SuperCoolAlan/wrx-manifests/systems/brake-notes.md

# Brake Notes — 04 WRX Chassis, Track Build

**Date:** 2026-08-19
**Build context:** 2004 USDM WRX chassis + 05-era EJ257, FP Red, E85, target 500whp, **mostly track use**
**Status:** Interim setup installed and adequate for 2026 season. Brembo upgrade planned as winter project.

---

## Current Configuration

### Confirmed (stated by Alan, 2026-08-19)

- **Front calipers:** OEM Subaru 4-piston, red, from a **2007 WRX Limited** (GD hawkeye)
- **Rear calipers:** OEM Subaru 2-piston, same donor era
- **Front knuckles:** **05-07 STi (GD-era)** — PN 28313FE060 + front bearing 28373FE000. **Alan-sourced deliberately to preserve GD suspension geometry**, NOT GR. (Confirmed 2026-08-19, superseding an earlier verbal 'GR knuckles'.)
- **Rear:** hubs from the 2011 swap + eBay; R180 rear diff
- **Bolt pattern: 5x114.3 all four corners** — fronts via the 05-07 STi knuckles/hubs, rears via the 2011 swap
- **Brake lines:** Stainless, already installed ✅
- These replaced the stock 02-05 WRX single-piston sliding front / single-piston rear setup

### Open / unverified

- **Exact rotor diameters.** Neither KNS nor its vendors publish the OD. Front is described as "the size and shape of a standard WRX rotor" (~294mm class, unconfirmed); rear matches 06-07 WRX OD and thickness. **Tape-measure them or ask KNS directly if a number is ever needed.**
- **How the 06-07 GD-era caliper brackets to the knuckle.** Either the mounting spacing is shared across generations or there is an adapter in place from the swap. Not blocking anything, but worth recording so it isn't rediscovered the hard way. (Note: KNS also sells V1.1 caliper conversion brackets — check whether a set is in there.)

---

## Rotors — RESOLVED 2026-08-19

**Part numbers used: KNS4651 (front) + KNS4656 (rear).** Made by **DBA (Disc Brakes Australia)** for KNS Brakes. NOT the 2011 donor rotors — an earlier recollection of "2011 rotors" was mistaken; the written note was correct.

### KNS4651 — front, 4-pot gravel rotor
Size and shape of a standard WRX rotor, but with a **larger center bore** and **dual-drilled 5x100 / 5x114.3**, so it bolts to any STI (or 15-21 WRX) front hub. This is the bridge part that makes 06-07 WRX 4-pot calipers work on 5x114.3 STI hubs.

### KNS4656 — rear, 2-pot gravel rotor
**Outer diameter and thickness of a 2006-07 WRX** rear rotor, but with the **parking brake drum sized for the R180 STI rear end**. The 2011 swap brought the R180 and STI rear hubs, so this rotor pairs the 06-07 WRX rear caliper to an STI rear end *and* keeps the e-brake functional. Dual-drilled 5x100 / 5x114.3.

Net: rear caliper and rear rotor OD are both 06-07 WRX spec — an OEM-correct pairing. **Fitment is correct by design. No pad-sweep or clearance check needed.**

### Construction
- **DBA XG-150 high-carbon alloy** — high-performance friction and wear characteristics
- **"Kangaroo Paw" pillar vane venting** — diamond and tear-drop pillars instead of straight vanes; DBA claims up to 20% better heat dissipation than straight-vane. Fronts vented similar to the Subaru Group N rotor.
- Genuinely good discs; resist the heat-checking and judder that kills cheap rotors on track.

### The catch for THIS build
These are **gravel rally rotors** — the diameter is deliberately held down so 15" gravel wheels clear the brakes (popular 15" gravel wheels cap around 300mm of rotor). Alan is on 17"+ tarmac and does not have that constraint. **Good metallurgy on a deliberately-undersized disc.** Gravel duty cycle (lower speeds, short stops, dirt cooling) is also the opposite load case from a 500whp tarmac track car.

Sold individually at most vendors — budget per corner when replacing.

**Vendors:** FastWRX, Flatirons Tuning, Bleeding Tarmac. Manufacturer: knsbrakes.com

---

## Assessment for This Build

**Verdict: sufficient for now, plan the upgrade.**

What the 4/2-pot swap actually bought vs the stock 04 setup:

- Fixed 4-piston front caliper instead of a sliding single-pot — much stiffer, even pad pressure across the pad face, no slide-pin binding. Real gain in pedal feel and consistency.
- Larger pad footprint — more friction area, slower wear.
- **Rear is the underrated half:** 266mm solid → ~290mm vented is a genuine upgrade.

What it did **not** buy, and why it matters here:

- **Front rotor diameter is essentially unchanged from the stock 04 WRX (~294mm).** Front thermal mass is the number that governs a 500whp track car, and it did not move. No pad compound fixes a rotor too small to absorb the energy. Expect consistent early laps and progressive fade as heat soaks over a session.

Caliper count is not the limiter — brake torque is already enough to lock the tires at any speed. **Heat capacity and pad compound are the limiters.**

---

## Phase 1 — This Season (interim, on current hardware)

| Item | Status | Notes |
|---|---|---|
| Stainless lines | ✅ **DONE** | |
| Front brake ducts | ☐ TO DO | **Highest-value remaining item.** See below. |
| Track pads | ☐ TO DO | Carbotech XP8/XP10, Hawk DTC-60, or PFC 08 — all listed for 06-07 WRX |
| High-temp fluid | ☐ TO DO | Motul RBF600/660 or Castrol SRF. **Flush before every event, not every season.** |
| Caliper piston + boot check | ☐ TO DO | Once, before first event. 2007 US car, so low-risk, but a sticking piston you can't feel on the street will cook a corner on track. |

**Pad availability is a non-issue.** 06-07 WRX is a common USDM application — Carbotech, Hawk, PFC, StopTech all support it. (Earlier concern about thin track-compound selection applied to JDM Version 5/6 calipers and does not apply here.)

**Front brake ducts — why this is the priority.** It's fabrication rather than a part you order, which is exactly why it gets skipped. With a 294mm front rotor you are leaning on airflow to compensate for missing thermal mass. GD front bumper has usable lower openings; standard approach is 3" ducting to a backing plate at the hub. This is the difference between fading on lap 4 and running consistent all session.

Keep a separate street pad set — endurance compounds are miserable cold.

---

## Phase 2 — Winter Project: 04-07 STI Brembos

**Direct bolt-on.** Front knuckles are 05-07 STi, so the **GD-era (04-07) STI Brembo** is the caliper that brackets up — **NOT the 08-14 GR caliper.** Hubs are already 5x114.3, so no conversion.

### Parts
- Front: **04-07 STI Brembo 4-piston calipers** + **326mm x 30mm rotors, 5x114.3**
- Rear: 04-07 STI Brembo 2-piston calipers + ~316mm rotors, 5x114.3
- Brake lines: GD/STI length — do not reuse the current set
- Pads: full track-compound selection available for the Brembo shape

### Caliper year nuance
The 04-07 STI Brembo **caliper and bracket are common across those years** — only the hub bolt pattern changed (04 = 5x100, 05-07 = 5x114.3). **Bolt pattern lives in the rotor/hub, not the caliper**, so a caliper off any 04-07 STI works. Just make sure the **rotors** are the 5x114.3 326mm parts.

Supply is thinner than the 08-14 sets but still common. Buy on caliper condition; rebuild seals if history is unknown.

### Verify before/during

- **Wheel clearance for 326mm.** 17" is the floor, but barrel shape matters as much as diameter. Test-fit before committing.
  **Wheels identified 2026-09-02: 17x8 ET55, 5x114.3, Enkei-cast Subaru OEM.** Castings read `17X8J 55`, Enkei logo, `MAT` (Enkei's casting process, not a spec), `Subaru C53` (mould ID, not a spec). ET55 rules out the 05-07 STI BBS wheel (+53). **Alan identified them from face-design photos as the 15-21 WRX (VA) base wheel** (base model only in later years), corroborated against the NASIOC OEM wheel-spec master thread - the castings can't separate that from the 08-14 WRX wheel, since both are 17x8 +55. Wheel weight 10.5 kg (23.2 lb); **OEM tire size 235/45-17**, which is the size to shop for track rubber.

  **Clearance outlook is POOR, corrected 2026-09-02.** The VA base wheel runs **316 x 30 mm front rotors with single-piston SLIDING calipers** - a larger rotor than the GD, but one of the slimmest caliper profiles Subaru ships. Radial clearance is a non-issue (326 vs 316 mm = 5 mm more radius); **lateral spoke clearance is the problem**, because a 4-pot Brembo is far wider and taller than the slider these wheels were drawn around. Forum consensus is that most 17" wheels do not clear 4-pot Brembos, and the ones that do are a short list (ADV.1 AV06, Method 501/502, Sparco Terra) that does not include OEM VA wheels. **Plan on needing different wheels if the Brembo swap goes ahead** - 18", or one of the short-list 17s. Test-fit with a caliper in hand before buying either. Size is no longer the unknown; spoke and barrel shape still are, and 17" is marginal on a 326mm Brembo.
- **Master cylinder.** Going to 326/316 increases fluid displacement again. If the pedal goes long after a proper bleed, that's displacement, not air — the STI master cylinder is the fix. **Bore sizes need verification against a parts catalog; not recorded here because they haven't been confirmed.**

---

## Decision log

**2026-09-02 - No track day this season** (weather/money/time). Track prep deferred, not cancelled. Remaining near-term work is bed-in, a piston/boot check on the used 07 calipers, and fresh ATE Typ 200. Ducts, track pads and track fluid wait until a day is actually booked.

**Installed pads identified 2026-09-02: Hawk HB700B.562.** `HB700` = 06-07 WRX front shape (corroborates the 07 WRX Limited 4-pot fronts independently of the caliper ID), `B` = **HPS 5.0** compound, `.562` = 14.3 mm. HPS 5.0 sits between HPS and HP+ - a high-performance *street* pad. **Correct for break-in**; a race compound would be worse here, since those need heat and chew rotors cold. **Not adequate for track** on 294 mm fronts with no ducts. When track pads are bought, **`HB700` is the front shape code**; rears need their own.

**Chosen deliberately by Alan for cold-weather bite** - not a default or a leftover. Track compounds are weak until they have heat in them, which on a winter street car means the first stop of the day is the compromised one. **Do not suggest swapping to a track compound for street/winter use.** The track pads are an additional set for track days, not a replacement.

**2026-09-02 — Brembo upgrade dropped.** Scope is now pads, fluid and front ducts on the existing 4/2-pot setup. Driver: the 15-21 WRX VA wheels won't reliably clear 326mm 4-pot Brembos (see the wheel-clearance note above), so the caliper swap carries a wheel purchase. With the front rotor fixed at ~294mm, **cooling and pad compound are the remaining levers** — which is what the ducts and pad selection below are for.

## Open Items

- [ ] Measure or source exact rotor OD/thickness for KNS4651 + KNS4656 (not published by vendors) — only needed if specifying pads or comparing to Brembo sizing
- [ ] Determine whether an adapter sits between the 06-07 calipers and the 05-07 STi knuckles (likely native — both GD-era) (possibly KNS V1.1 conversion brackets)
- [ ] Confirm rear rotor diameter on the current setup (~290mm assumed, unverified)
- [ ] Verify STI vs WRX master cylinder bore sizes against catalog before any MC purchase
- [ ] Watch front vs rear pad wear rates over the first couple of events — GD proportioning was set for the stock front caliper, and under-used rears mean the fronts eat all the heat
- [ ] Add a BRAKES section to the master build spreadsheet

---

## Reference

Master build spreadsheet: https://docs.google.com/spreadsheets/d/1KrntpsHHwKKx_W9Vn28aLq9sGWfUYiJAk4-rHiAo67w/edit

Related notes: `cooling-system-notes.md`, `turbo_research_notes.md`, `break-in-protocol.md`
