SuperCoolAlan/wrx-manifests/systems/aps_dr725_kit_inventory.md

# APS DR725 FMIC Kit — Expected Inventory & Verification

## Kit identification

- **Manufacturer:** Air Power Systems (APS Performance), Australia — defunct, original site (airpowersystems.com) is dead
- **Model:** D/R Series 725 Front Mount Intercooler — "DR725"
- **Variants:**
  - `WRX-FMI/R4` — polished/silver piping
  - `WRX-FMI/R4B` — black piping (some kits "crinkle red")
- **Application:** 2002-2005 WRX/STI primary; 2006-2007 fitment requires extra/different parts
- **Power rating:** 500-725 hp (50-75 lb/min turbo)
- **Core:** 28" × 9.5" × 4.5" bar-and-plate, ~266 sq in face, ~1,197 cu in volume

## Year-specific notes

The kit shipped with **different parts for 02-03 vs 04-05 vs 06-07**. Things that change year to year:
- Bumper beam bracket geometry (crash structure differs)
- Crossover hose length through the fenderwell
- Some bracket / hardware kits are year-specific

User chassis = **2004 WRX** → standard 04-05 install kit applies.

---

## Expected components — verification checklist

Mark each as you find it in your inventory.

### Core components

- [ ] **DR725 intercooler core** (28" × 9.5" × 4.5", bar-and-plate)
- [ ] **Mounting bracket / bumper beam replacement** (bolt-on, structural — maintains fog lights)
- [ ] **Coolant overflow bottle (relocated)** + mounting bracket
- [ ] **Turbosmart Raceport BOV** (VTA — vent-to-atmosphere)
  - Some kits included a recirc adapter; with VTA Raceport, recirc usually NOT needed

### Charge piping (stainless steel — heavy, rigid)

Per forum reports, the DR725 ships with hard piping connecting to the FMIC via couplers, plus one longer silicone hose section through the fenderwell.

- [ ] **Turbo outlet pipe** (short, hard SS — connects turbo compressor to first coupler)
- [ ] **Cold-side fenderwell crossover pipe** (routes from turbo around radiator support to FMIC inlet)
- [ ] **Hot-side pipe** (FMIC outlet → over/around radiator to throttle body side)
- [ ] **Throttle body inlet pipe** (often integrated with the hot-side pipe; ends at TB coupler)

### Silicone couplers (estimated 5-7 total — verify exact count)

| # | Position | Coupler type | Approx size |
|---|---|---|---|
| 1 | Turbo outlet → cold-side hard pipe | **Reducer**, often 90° | ~2" turbo → 2.5" pipe |
| 2 | Cold-side pipe → fenderwell silicone hose | Straight | 2.5" |
| 3 | **Fenderwell silicone hose** (long, ~8" through fender area) | Straight silicone hose, NOT a coupler | 2.5" |
| 4 | Crossover hose → FMIC inlet | Straight or 45° | 2.5" |
| 5 | FMIC outlet → hot-side pipe | Straight or 45° | 2.5"-3" |
| 6 | Hot-side pipe → BPV/BOV bung *(if welded T)* OR T-coupler with BOV branch | T-fitting / silicone | varies |
| 7 | Hot-side pipe → throttle body | **Reducer** | ~3"/65mm → 60mm TB |

**Coupler totals:**
- [ ] Count of straight couplers: ____
- [ ] Count of reducer couplers: ____
- [ ] Count of 90°/45° elbow couplers: ____
- [ ] Long fenderwell silicone hose (~8"): ____

### Hardware & clamps

- [ ] **T-bolt clamps** (heavy duty, stainless) — should match coupler count × 2 (one per side of each coupler)
- [ ] **Worm-gear clamps** (lighter duty, may be used on smaller hoses) — for BOV vacuum line, BPV plumbing
- [ ] **Mounting bolts/nuts** for bumper bracket
- [ ] **Mounting bolts/nuts** for FMIC core to bracket
- [ ] **Fender-side hardware** (some kits include captive nuts / rivnuts for radiator support fasteners)
- [ ] **BOV vacuum line** + barb fitting

### Optional / sometimes bundled

- [ ] **APS 65mm Cold Air Intake** (sometimes included, sometimes sold separately — check if you have it)
- [ ] **Replacement hood scoop block-off plate** (since hood scoop is no longer needed for TMIC airflow)
- [ ] **Original install instructions** (paper or PDF — if you have it, scan it for reference)

---

## Known issues / things that often need addressing

### Fitment quirks documented in forums

- **Timing belt cover clearance** — turbo-side piping can rub the timing belt cover. Some installers grind a small relief or use slight routing tweak. Watch for this on install.
- **Hood scoop / cold air intake conflict** — the hot-side charge pipe routes through the area where the OEM TMIC sat, which is also where stock-style cold air intakes route. **This is your known issue** (per build notes).
- **Crank pulley / lower radiator hose clearance** — cold-side piping can be tight here on some chassis.
- **Stainless steel piping is heavy and rigid** — install requires patience, dry-fit everything before final tightening, otherwise you'll fight alignment.

### Commonly missing or worn-out parts on used kits

When inventorying a used kit, these are the most-commonly-lost or replaced items:

- ⚠️ **Silicone couplers** — can dry out, crack at clamp marks, or get cut up during removal
- ⚠️ **T-bolt clamps** — sometimes seller keeps "the good ones" for their next build
- ⚠️ **Coolant overflow bottle bracket** — easily lost during disassembly
- ⚠️ **BOV vacuum line + fittings** — often missing
- ⚠️ **Original BOV** — sometimes swapped for a different brand / sold separately
- ⚠️ **Mounting hardware bag** — bolts/washers commonly lost
- ⚠️ **Year-specific bracket pieces** if kit was originally for a different year

---

## Replacement source plan (for missing parts)

### Silicone couplers

Standard sizes can be sourced separately from:
- **Vibrant Performance** — common quality silicone couplers, available at Summit, JEGS, Amazon
- **Mishimoto** — also makes individual couplers
- **Siliconehoses.com** — wide selection, custom sizes
- **eBay** — generic 4-ply silicone couplers ~$10-25 each (acceptable for non-critical positions; verify wall thickness)

For a **5-7 coupler restock** plus T-bolt clamps, budget **$80-200** depending on quality tier.

### T-bolt clamps

- **Norma / Mikalor** — German-made T-bolts, ~$5-8 each, the gold standard
- **Vibrant** — solid mid-tier, ~$4-6 each
- **eBay generic** — $1-3 each, fine for non-pressure-critical positions
- Buy 2-4 spares — they're consumables and you'll need them eventually

### BOV / BPV

If the Turbosmart Raceport is missing:
- **Turbosmart Raceport new** — ~$280-330
- **Turbosmart Kompact Plumb Back** (recirc version) — ~$280-330 — better for the FMIC + Link standalone tune
- **Tial Q 50mm** — ~$280-350, popular alternative
- **GFB Respons / TMS** — ~$200-280 mid-tier options

### Coolant overflow bottle

- **OEM Subaru coolant bottle** — fits but mounting may differ
- **Aftermarket round overflow tank** (Spectre, Mishimoto, Aeromotive) — ~$30-80
- 3D-printed mount can fill the gap if the original bracket is missing

### Hardware

- **OEM Subaru bumper beam hardware** — fits, available from any dealer
- **Generic 8.8 metric bolts** for non-structural mounts — hardware store

---

## Action items

1. **Spread the kit out and photograph it** — multiple angles, every component
2. **Count the silicone couplers** — note size (use calipers if you have them) and shape (straight, reducer, elbow)
3. **Compare to the inventory checklist above** — mark what's present, what's missing
4. **Check coupler condition** — flexion, no cracks at clamp marks, no oil saturation
5. **Identify the year-variant** — does the bumper bracket match 04-05 WRX geometry?
6. **Decide:** restock missing silicones + clamps as a single $80-200 order, or just buy a complete set new from Vibrant/Mishimoto for a clean baseline
7. **Bench-fit before engine install** — dry-fit the whole charge path on the bumper before committing to engine assembly order

---

## Open questions to resolve before install

- [ ] Does your APS 65mm CAI fit alongside the FMIC piping? (Per earlier notes — known conflict; may need to route differently or replace)
- [ ] Is the coolant overflow bottle present + bracket usable?
- [ ] Is the original bumper-beam bracket structurally sound (no cracks, bent mounts)?
- [ ] BOV — is it still the Turbosmart Raceport, or has it been swapped?
- [ ] Throttle body coupler — is the 65mm or 60mm reducer present? (Critical — TB is 60mm OEM)
- [ ] Any year-variant mismatch (e.g., 02-03 hardware on a 04+ kit)?
- [ ] Were the sealing surfaces (FMIC inlet/outlet flanges, hard pipe ends) all coupler-grade clean, or have they been scuffed?

---

## Sources for reference

- [Air Power Systems — DR725 install page (DEAD — domain parked)](http://www.airpowersystems.com/wrx/apswrx-fmi-r4/fmi_r4_install.htm)
- [NASIOC — APS D/R 725 Intercoolers main thread](https://forums.nasioc.com/forums/showthread.php?t=897975)
- [WeSellCarParts — APS WRX-FMI/R4B product listing](http://www.wesellcarparts.com/store/scripts/prodView.asp?idproduct=9034)
- [NASIOC — FS listing with 06-07 install kit detail](https://forums.nasioc.com/forums/showthread.php?t=2074786)
- [IW STi — DR725 fitment issues with pictures](https://www.iwsti.com/threads/aps-dr725-fmic-fitment-issues-with-picts.118486/)
- [IW STi — APS FMIC piping only thread](https://www.iwsti.com/threads/aps-fmic-piping-only.200605/)
- [ScoobyNet — DR725 review thread](https://www.scoobynet.com/general-technical-10/630106-aps-dr725-front-mount-intercooler.html)
- [ClubWRX media — DR725 photo](https://www.clubwrx.net/media/aps-dr725-fmic-perfect-for-high-horsepower-subis.91484/)

## Wayback Machine fallback

If you want to dig deeper on the original APS install page (web.archive.org blocks me but you can browse it):

**Try:** https://web.archive.org/web/2010*/airpowersystems.com

Look for snapshots from 2008-2012 (the DR725's prime sales window) — the install page with the full parts diagram should be there if it was ever indexed.
