SuperCoolAlan/wrx-manifests/(list of files, cad)

Other CAD files:
3D Prints/battery-tray/m5-insert-test-prints/fuse-insert-dia-test-3.scad
3D Prints/battery-tray/m5-insert-test-prints/fuse-insert-dia-test.scad
