SuperCoolAlan/wrx-manifests/(commit log)

2026-08-20 Initial commit: WRX build documentation
    Consolidates build documentation into a single versioned store.
    Absorbs 20-21 2004 Wagon Build.xlsx from Dropbox, which is now
    superseded. Its bearing-clearance measurements and small-part
    numbers existed nowhere else and were at risk of being lost.
    New:
    - parts-register.md aftermarket parts keyed to what they supersede
    - as-built-engine-specs.md measured bearing clearances, machining notes
    - hardware-reference.md seal/bushing/axle/fastener/connector PNs
    .gitignore excludes the title scan, insurance and receipts. Git
    history is permanent, so these must never be committed.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
2026-08-20 Fold CPU-75 answers into the register and system notes
    Stabilizer bars confirmed as wagon spec, which also confirms the
    Wagon/Except-STi torque branch used throughout the suspension notes.
    Clutch fork came with the 2011 6MT, so it is the 6MT part. The
    forum-vs-FSM evidence split is moot for this car.
    Intake manifold recorded as likely-2005 with the reasoning, not as
    confirmed. Head casting and BC coilover PN remain open.
    Claude-Session: https://claude.ai/code/session_01F5AUh1XUcGjMrdWtMARPJ6
2026-08-20 Absorb build sheet data: injectors, plugs, ECU model, fluids
    Sheets MCP now reachable, so the master build sheet is readable. Adds 13
    parts and fills in five previously-unknown or vague rows.
    Closes two open questions:
    - Injectors are DeatschWerks DW1500 (16M-07-1500-4)
    - Header bung is M18 x 1.5, confirmed via the Prosport oil pressure hose
    kit, which ships an M18x1.5 galley adapter. The plug that came out of
    that galley fits the header bung, so the chain closes.
    Register is 78 parts, 3 unknowns remaining.
    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
2026-08-20 Absorb the To Buy tier from the build sheet; split brake/clutch bleed
    Adds 20 rows from the non-Installed statuses, which had not been read
    before: turbo drain line, oil drain T-fitting, DC Power 180A alternator,
    Big 3 wiring, serpentine belt, flex sensor and adapters, fuel pressure
    sensor, Bosch LSU 4.9, MAF retained for IAT, PS pump rebuild kit,
    Mishimoto radiator hoses, RCM/Samco coolant hose kit.
    FP Red PN recorded as R690701874, HTZ variant.
    BOV left explicitly undecided. The sheet records a leaning toward a
    pure-recirc hose-mount body, but that is a leaning, not a decision.
    Register is 97 parts.
    Claude-Session: http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
2026-08-20 Crank pulley: running the Perrin, Fluidampr deferred
    Reverses the 2026-07-02 decision. The Perrin lightweight pulley is
    already installed and stays; the Fluidampr is not being bought for now.
    Original rationale kept on the deferred row rather than deleted, since
    the reasoning is still valid if the decision is revisited. Mitigating
    factor: the OEM conventional flywheel means the lightweight-pulley plus
    lightweight-flywheel combination is avoided.
    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
2026-08-20 Correct intake PN to AEM 21-474; note test fit
    Build sheet said 21-477. Actual part is 21-474, listed for 02-05 WRX
    rather than STI, but test fitted and mates to the FP 84mm inlet with a
    silicone reducing coupler.
    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
2026-08-20 AVCS feed lines: HEL-OF34 braided, both sides
    Replaces the split plan of OEM driver side plus TBD passenger side.
    HEL fitment spans 04-21 STI, so this part is unaffected by the
    unresolved head-casting question.
    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
2026-08-20 AVCS feed lines are mixed: OEM driver side, HEL passenger side
    Split into two rows. The sides use different sealing hardware and
    different torque specs, so one row could not describe both.
    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
2026-08-20 Alternator resolved: 200A/220A peak custom build, $449
    Supersedes both options the notes were deciding between. The notes had
    been left in a REOPENED state since 2026-05-30 while the build sheet
    still said DC Power 180A — neither was current.
    Records the 14.8V regulator and 150A idle output, and flags three
    verifications: pulley sizing for the belt, battery charge-voltage
    compatibility, and charge-wire fusing at more than double the OEM
    alternator output.
    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
2026-08-20 Alternator is Michael Singer 200A; correct battery location
    Builder identified as Michael Singer, which connects the long-standing
    singer-alternator-spec-request.md to the outcome. Denso case, direct
    replacement for 23700AA430, 150A idle, 14.8V regulator.
    Corrects an error I introduced: the battery was recorded as relocated to
    the rear cargo area. It is in the engine bay, OEM location, per the
    battery tray build notes. The rear routing in the fuel pump notes is a
    feed to the pump, not a battery move.
    Consequences: the 250A ANL fusing and MEGA holders on the tray already
    cover the charge wire, and the 14.8V setpoint was Singer's answer to a
    direct question about an AGM battery — both conc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
2026-08-20 Belts confirmed: 5PK875 front, 4PK895 rear
    Corrects a wrong steer toward 5PK880, which came from a single outlier
    listing. Mitsuboshi and MOCA sets both pair 4PK895 with 5PK875, and the
    Gates equivalent K050345 decodes to 344K5 = 5 ribs x 875mm.
    Mitsuboshi appears to be the factory supplier for the front belt rather
    than Bando; both are OE-tier.
    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
2026-08-20 Add exhaust gaskets, crank pulley bolt, filters and crush washers
    Exhaust gaskets confirmed in stock. The crank pulley bolt, oil filters
    and crush washers existed only as prose inside task descriptions and
    were not tracked as parts.
    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
2026-08-20 AVCS LH line and new crank pulley bolt both installed
    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
2026-08-20 Expand engine-heads from 3 rows to 9
    Cosworth heads, not just Cosworth valves — ported, polished, flow matched
    between banks, valve spring seats machined for taller springs.
    ARP head studs confirmed, which closes the main reliability question at
    this power level. Deck surface not milled, so compression stays at the
    8.5:1 the dish pistons give and cam timing geometry is unchanged.
    Still unknown: valve sizes and material, valve stem seals, ARP kit PN,
    and who performed the porting. A for-sale thread for the heads exists
    and should be archived as the provenance document.
    Claude-Session: https://claude.ai/code/session_01F5AU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
2026-08-20 Heads are a mismatched pair: one Cosworth, one OEM ported to match
    Reframes what flow matching meant here — it was a matching exercise
    between two different heads, not a matched pair from one supplier.
    Raises an open question worth answering before the tune: whether the
    combustion chambers were cc'd and equalised. Flow matched does not imply
    chamber matched, and unequal chamber volume gives different compression
    bank to bank.
    Retainers are Cosworth PR7561, not Manley as previously recorded.
    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
2026-08-20 Head casting resolved: V25 STi Cosworth; chambers equalised
    Closes a question open since the start of this work. Corroborates the
    V25B casting mark already recorded in cooling-system-notes.md, which is
    what drove the 21141AA131 upper pipe choice.
    Binder consequence: head and valvetrain work follows the 2007 FSM, and
    since 2007 STi has no ME section, that means ME(H4DOTC). Noted in the
    print index.
    Chambers were equalised between the Cosworth head and the ported OEM
    head, so compression is even bank to bank.
    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
2026-08-20 Valve oversize recorded as +1mm recollection, not confirmed fact
    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
2026-08-20 Exhaust: midpipe is part of the XForce cat-back; all joints 3in
    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
2026-08-20 Add cooling as its own system; record radiator, fans, coolant plan
    Cooling had no category despite being Binder Tab 3 — parts were
    scattered through engine-lower. Now 10 rows: Mishimoto radiator, OEM
    fans, RCM water pump and thermostat, the three OEM hard lines, and the
    coolant plan.
    Coolant is green Asian-formula from a local store. Recorded with the
    distinction that matters: green is also the traditional colour of
    conventional IAT coolant, which is on the avoid list. Chemistry is on
    the label, not the bottle colour.
    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
2026-08-20 Add wheels and tires; flag Brembo clearance as unverified
    Wheels confirmed to clear the current 4/2-pot and ~294mm rotor setup.
    That does not confirm clearance for the planned 326mm Brembos — a 32mm
    larger rotor, where barrel shape matters as much as diameter.
    Records the identification method: spec is stamped on the inner barrel
    or behind a spoke.
    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
2026-08-20 Mark teardown-gated unknowns; expand ECFT description
    Valve sizes, stem seals and chamber cc figures are not discoverable with
    the engine assembled. Marked teardown-gated so they stop reading as
    actionable items — they belong with the clutch fork PN and ACT disc
    diameter, which are already batched to the next clutch job.
    ECFT row now explains what the acronym means rather than assuming it.
    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
2026-08-20 Radiator is Mishimoto MMRAD-WRX-01; record the two supplied caps
    Records the cap distinction, which is easy to get wrong: one-way on the
    radiator, two-way on the ECFT, and they are not interchangeable.
    1.3 bar is well above the OEM 0.9 bar. Acceptable here because the ECFT
    is the aluminium Mishimoto rather than the OEM plastic tank.
    Flags one open fitment check: whether the OEM fan shrouds mount to it.
    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
2026-08-20 OEM fan shroud confirmed to mount to the Mishimoto radiator
    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
2026-08-20 Valve stem seals were new for the build
    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
2026-08-20 Correct print index; retire print-manifest.md
    Two real errors fixed:
    - SC(H4DOTC) is itself a stub pointing at SC(H4SO). The index listed the
    2-page stub, which would have printed another cross-reference instead
    of content. Now points at the 22-page H4SO file.
    - Tab 2 told you to use STi sections and not H4DOTC, while the head note
    above it said to use ME(H4DOTC). Reconciled, and the 2007 head section
    is now an actual printable row rather than only prose.
    Also flags content superseded since the index was written: fluids and
    periodic maintenance, charging specs (Singer 200A), and the exhaust
    section (entirely aftermarket, catless).
    Tab 9 now points at real repo paths — 10 of its 1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
2026-08-20 Manual generators: shared traps, 2004 suspension, H4SO explanation
    Traps are now defined once in build-manual.py and tagged by tab. The TOC
    imports them, so the front-of-binder list and the per-tab covers cannot
    drift apart. Dropped the bushing re-torque line from the traps list — it
    is a procedure item, not a which-manual trap, and it already appears on
    the Tab 6 cover.
    Tab 6 gains the 2004 front and rear suspension sections. The chassis is a
    2004 GG wagon, so subframe, link mounting and wagon torques come from
    2004 — that year was missing while 2007 and 2005 covered the STi
    knuckles. All three are needed and the cover now says which does what.
    Tab 3 cover explains why an H4SO file is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
2026-08-20 Write the manual for the next owner, not for the build
    Reframing: assume the reader is someone who receives a finished car and
    knows none of the context. That changes what belongs in a printed binder.
    Adds TAB0a_READ-FIRST — the orientation page that was missing. A stranger
    opening this binder would not know the car is 5x114.3 rather than 5x100,
    that it runs E85 with a flex sensor, or that a generic OBD-II scanner
    failing to connect is expected rather than a fault. That page says so
    before they touch anything.
    Strips build-progress language from the PDFs. What is ordered or not yet
    installed is Linear's job and goes stale the day it changes; the binder
    should describe what the car is.
    S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
2026-08-20 READ-FIRST: give the drivetrain its own section, paginate
    The page said the manual comes from three years and listed 2004, 2005 and
    2007 — but the transmission is a 2011 unit, a fourth source that is not
    printed at all. Someone reading that heading and then finding a 2011
    gearbox had no way to know which pages applied.
    Now explains that no 2011 sections are printed, that the 2007 manual is
    the readable proxy, and that torque and fluid figures must be verified
    against a 2011 manual.
    Two more things a new owner would get wrong: DCCD is controlled by an
    aftermarket iWire Spiider rather than the factory controller, so the
    Control Systems section describes hardware this car does not have; and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
2026-08-20 DCCD controller is DCCDPro, not 'iWire Spiider'
    The build sheet called it an iWire DCCD Spiider, which is how it entered
    these records. It is a DCCDPro unit, supplied via iWire with the harness
    merge. Both names kept on the parts row so the sheet entry is traceable.
    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
2026-08-20 Fold in both invoices; correct the DCCD claim
    CORRECTION: I wrote that the factory DCCD switches were absent. They are
    not — the factory knob and cluster display work normally. The invoice
    supports this: "DCCDPro with cluster output" plus a DCCD Cluster Jumper.
    DCCDPro sits behind the factory controls adding automatic G-sensor modes.
    Fixed in READ-FIRST and on the Tab 4 cover.
    Also resolves the DCCDPro / Spiider confusion — they are two parts.
    DCCDPro is the controller ($490); the DCCD Spiider PnP Kit ($154.99) is
    the harness that connects it.
    From BW Tuning invoice AS-0003:
    - ECU is WRXLink WRX104X (224-4000), not G4X Fury, installed into the
    factory ECU enclosure, bench-activated w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
2026-08-20 Track parts.csv in git; add sensor + boost control rows
    parts.csv was matched by the blanket *.csv ignore rule, so the source of
    truth for parts-register.md was never committed - only its generated
    output. Added a negation so it is tracked.
    Merged two duplicate rows (AOS was entered twice, flex fuel sensor was
    entered twice under different systems).
    New rows from this session: knock sensor (new OEM, on hand), crank and
    cam position sensors (new, not OEM), coolant temp sensor (new), AVCS
    solenoids (used, came with the heads), GrimmSpeed 3-port EBCS, and the
    TiAL black+blue spring stack.
    Corrected the valvetrain to SINGLE AVCS - intake only, one solenoid per
    head. The two AVCS oil feed line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
    [parts.csv]
2026-08-20 Add OEM exhaust studs/nuts and Y breather fitting
    All three in stock, sourced OEM from the dealership. Exhaust manifold nut
    torque confirmed from FSM EX(H4DOTC)-4 STI exploded view: T3 = 35 N.m.
    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
    [parts.csv]
2026-08-20 Add MEGA fuse holders and the two fuses (not yet in stock)
    The battery tray's fuse platform was designed around Blue Sea 5001-style
    MEGA holders, but electrical-grounding-notes.md specs a 250-300A ANL fuse.
    ANL and MEGA are different form factors and are not interchangeable. The
    tray is printed, so MEGA governs. Flagged in the register notes.
    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
    [parts.csv]
2026-08-20 Merge hardware-reference.md into parts.csv as the single source of truth
    The seals, axles, hubs, bushings and gauge-harness connector BOM lived only
    in hardware-reference.md, which the register generator never read. Searching
    parts-register.md for "axle" returned nothing while the answer sat one file
    over - that split caused a bad gap audit earlier in this session.
    30 rows merged, including a new "tools" system for the assembly tools, which
    are not on the car and so carry no binder tab. Its rollup comes to $73.72,
    matching the source spreadsheet's Tools total exactly.
    Corrections made while merging: exhaust manifold nuts are PN 902370029, and
    the manifold studs were REUSED, not purchased -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
    [parts.csv]
2026-08-20 Fuel rails confirmed as Aeromotive AER14134
    Resolves the conflict inherited from the 20-21 wagon spreadsheet, which
    listed an early IAG rail. The spreadsheet was wrong.
    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
    [parts.csv]
2026-08-20 Close out Tier B: 2004 chassis parts carried over
    Recorded from Alan's direct confirmation. The theme is that far more of the
    2004 chassis carried over than the hybrid drivetrain would suggest:
    - Parking brake cables: 2004 originals, VERIFIED holding on the KNS discs
    despite the 05-07 STi rear knuckles
    - Transmission crossmember: 2004 original, carrying the 2011 6MT
    - Clutch line, shifter linkage, steering rack: all stock 2004
    From the 6MT: transmission mount. From the ACT Stage 2 kit: throwout
    bearing, which makes the bearing 6MT-spec. The release FORK origin is
    still unknown and stays open.
    Claude-Session: https://clau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
    [parts.csv]
2026-08-20 Release fork confirmed 2011 6MT OEM - clutch actuation question CLOSED
    Open since 2026-08-19. The fork came off the 2011 6MT swap, which makes the
    release stack 6MT throughout: 6MT flywheel, ACT Stage 2 clutch, 6MT fork,
    ACT-supplied bearing, with the 2004 pedal/MC/line/slave carrying over.
    That is exactly the internally-consistent stack the NASIOC 1881656 analysis
    argued for, and the opposite of the mixed WRX/STi stack that failed there.
    Bore sizes remain unverified - flagged at the clutch bleed.
    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
    [parts.csv]
2026-08-20 Add Hawk brake pads; fix manual build reproducibility
    Pads recorded as Hawk, compound still unidentified.
    Manual build fixes:
    - build-manual.py now guards its build behind main(), so importing TRAPS
    has no side effects. Loading it via importlib previously ran the whole
    build, which overwrote the tab PDFs using only the 2007 sources.
    - build-toc.py loads TRAPS by file path; the plain 'from build_manual
    import' had been broken outright by the hyphenated filename.
    - SRC reads WRX_FSM_SRC instead of a hardcoded path that did not exist.
    - Preflight check names missing FSM year roots instead of silently
    dropping whole tabs.
    The tab PDFs need regenerating once the 2004/2005 manuals are on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
    [parts.csv]
2026-08-20 Manual pass: today's findings, and stop the TOC silently dropping traps
    Content:
    - SINGLE AVCS gets its own READ-FIRST section and a Tab 2 trap. The engine
    sections come from a 2007 DUAL AVCS manual, so the exhaust-side sprockets,
    solenoids and oil passages in those figures do not exist on this engine.
    - Clutch stack rewritten now that the fork is confirmed 2011 6MT. The old
    text still framed the fork as an open question.
    - New READ-FIRST section on the 2004 carryover: the 2011 gearbox sits in the
    2004 crossmember, uses the 2004 shifter and clutch line, and the steering
    rack is also 2004. Counterintuitive enough to send someone ordering the
    wrong parts.
    - Boost floor gets a READ-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
2026-08-20 Add AS-WIRED register: wiring deviations as data, not PDF annotations
    The FSM wiring diagrams already do not describe this car, so annotating them
    would make a wholesale-wrong document look partially right. Instead TAB 7a
    prints in front of them and supersedes them for every circuit listed.
    - as-built/wiring.csv, seeded with 19 deviations recoverable from the iWire
    and Link invoices and existing notes
    - tools/gen-wiring-register.py -> as-built/wiring-register.md
    - manual/build-aswired.py -> TAB7a_AS-WIRED.pdf
    - Tab 7 trap points at it, and records that the handwritten Link pin notes
    outrank any printed pinout
    Both generated views report how many rows carry pin-level detail. It is
    curre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
2026-08-20 Trim non-deviations from the wiring register
    Cam position sensor removed per Alan - it mimics OEM, so it is a part, not a
    harness change. Knock sensor removed on the same reasoning: a new OEM sensor
    in the OEM location is not a deviation. Its 24 N.m / 60-degree spec already
    lives in the Tab 7 traps and CPU-82, so nothing is lost.
    Both remain in parts.csv. The wiring register is for circuits that differ
    from the FSM diagrams; anything that matches OEM belongs only in parts.
    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
2026-08-20 Drop crank position sensor from the wiring register; write down the rule
    Same reasoning as the cam sensor and knock sensor: aftermarket but mimics
    OEM, so it is a part rather than a harness change. Still in parts.csv.
    Recorded the inclusion rule in the generator docstring so the register does
    not drift back into being a parts list. 16 deviations remain, all of them
    circuits that actually differ from the FSM diagrams.
    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
2026-08-21 Track all as-built CSVs; drop committed pycache
    wiring.csv was hitting the same blanket *.csv rule that parts.csv did. That
    was fixed by name last time, which left the trap in place for the next CSV -
    and the next CSV arrived a day later. The rule now exempts as-built/*.csv as
    a class, since everything in that directory is a source its .md is generated
    from.
    Also removed a stray __pycache__ entry that got committed when build-manual.py
    was first imported, and ignored those going forward.
    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
    [wiring.csv]
2026-08-21 Record the DW400 fuel pump hardwire (FPHWK-10-HD)
    Six rows covering the run, relay, grounds and the trigger splice.
    The important one: the factory fuel pump control module is STILL FITTED AND
    STILL PLUGGED IN, but its 12V feed was spliced away to trigger the new relay,
    so it receives nothing and does nothing. Someone chasing a fuel-side no-start
    would find a module that looks live, measure it dead, and lose a day. That is
    now a Tab 7 trap, a READ-FIRST void-list entry, and a Tab 7a row.
    Also recorded that the relay output deliberately lands on the chassis harness
    rather than running straight to the pump, so the pump stays disconnectable for
    tank service.
    Still missing: FPCM connector ID,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
    [wiring.csv]
2026-08-21 Correct the FPCM record: it is still in the signal path, not dead
    Reversed an earlier entry that said the factory fuel pump control module was
    dead and should be ignored. Alan cut the wire that originally landed on R58
    pin 1 and redirected it to the relay trigger, which means the FPCM output is
    what closes the relay. If the FPCM fails, the pump never runs.
    The previous wording would have told someone to skip the one module that can
    strand the car, and to consider removing it.
    Connector identifications confirmed against FSM WI-189/190 and diagram
    E/G(TB)-01 on WI-82:
    - R15 16-pin, rear wiring harness (chassis side)
    - R57 16-pin, fuel tank cord - entry to the pump harness
    - R58 6-pin, fue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
    [wiring.csv]
2026-08-21 Fuel pump wiring: separate the two taps, FPCM is unplugged
    Third and final version of this circuit. The confusion was mine: there are
    TWO taps and I kept collapsing them into one.
    - Relay TRIGGER (blue): 12V spliced from the OEM fuel pump controller
    circuit, which is why the FPCM sees no 12V.
    - Motor FEED (yellow): the BY wire between R57 and R58 is CUT, and R58 pin 1
    now takes high current straight from the relay output.
    So the FPCM is UNPLUGGED and genuinely out of the circuit - not dead-but-
    present as first written, and not in-the-signal-path as second written.
    Recorded the abandoned factory path as its own row, because tracing BOr at
    R15 pin 8 through R57 against WI-82 will misle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
    [wiring.csv]
2026-08-21 Record the ECU-to-FPCM control chain and where it is cut
    Alan traced the factory chain: ECM connector D pin 15 (GR) commands the fuel
    pump relay; the relay output (BY) runs B46 -> B97/R1 bulkhead -> R166/R167
    STi FPCM harness -> R122. Confirmed against FSM E/G(ST)-01 on WI-108, which
    shows GR at D15 and the B97/R1 pair as an 8-pin bulkhead in area B-2.
    The circuit is cut in TWO places, both spliced under the rear driver seat:
    the BY relay feed before R122, and the BY motor feed between R57 and R58.
    Everything upstream of the first cut is intact, which is how the new relay
    still follows factory pump-on logic.
    Flagged one discrepancy rather than smoothing it over: Alan records the feed
    landi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
    [wiring.csv]
2026-08-21 Cut is between R1 and R166, and the STi diagram is the governing one
    Alan spotted that the STi routing inserts the R166/R167 FPCM harness pair
    between R1 and R122, where the non-STi turbo routing runs R1 straight to
    R122. The cut sits BEFORE that pair, so R166, R167 and R122 are all dead
    downstream.
    Added a row and a trap naming E/G(ST)-01 on WI-108 as the diagram that
    applies, because the two versions are near-identical and the extra connector
    pair is easy to miss - which is exactly the mistake I would have led someone
    into by citing the turbo diagram.
    Claude-Session: https://claude.ai/code/session_01F5AUh1XUcGjMrdWtMARPJ6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
    [wiring.csv]
2026-08-21 R122 pin 10 confirmed; drop the pin-number discrepancy
    Alan's notes and FSM E/G(ST)-01 agree on pin 10 - the earlier pin 1 was a
    typo in conversation, not in the notes. Row moves to confirmed.
    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
    [wiring.csv]
2026-08-21 Record the local fuel pump ground and the abandoned factory return
    Pump ground leaves on the OEM path through R58 pin 4, then is tapped between
    R57 and R58 and grounded to chassis under the rear seat. The factory return
    per GND-04 (WI-26) ran R58 pin 4 -> R57 pin 16 -> R15 pin 16 -> forward to
    the GND-04 point at the front of the car; that run is sized for the stock
    pump and is no longer the return path.
    That makes three separate modifications to the R57-R58 segment, so it is now
    called out as such on the Tab 7 cover.
    Flagged one unknown rather than assuming: whether the original long ground
    wire was cut or left in parallel is not recorded.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
    [wiring.csv]
2026-08-21 Name both endpoints of the tapped ground wire
    The tap sits on the black wire spanning R58 pin 4 and R57 pin 16, so record
    both pins rather than only the pump-side one - either end is a valid probe
    point when tracing it.
    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
    [wiring.csv]
2026-08-21 Record why the factory pump ground was cut rather than paralleled
    GND-04 is a shared node carrying seat heaters, lights, door switches, the
    fan control amp and the compass mirror. Putting DW400 current on it would
    inject noise and shift the fuel level sender's ground reference, and the
    current split between two very different impedances is uncontrollable. Cut
    is correct; the tradeoff is that the local ground is now a single point of
    failure.
    Added a row for the fuel level sender, which shares R58 pin 4 and therefore
    now grounds locally too. Marked to-verify with a concrete check: if the fuel
    gauge misreads at first start, the cause is here, not a bad sender.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
    [wiring.csv]
2026-08-21 Correct the governing fuel pump diagram: body-side, so 2004 turbo
    I applied the 2005 STi ENGINE harness to a circuit that is entirely body-side
    wiring. The FPCM and the B46 -> B97/R1 -> R122 chain live in the rear body
    harness, which on this car is the original 2004 WRX. R166/R167 are indexed
    '(STi model)' meaning the STi CAR, not the STi engine, so a 2004 WRX should
    not have them.
    Trap now points at E/G(TB)-01 (WI-82) and explains the body-vs-engine harness
    distinction, since that is the reasoning error that caused this.
    Left one question open rather than papering over it: Alan traced the run
    through R166/R167, which the turbo routing does not have. Flagged as a
    physical check for an extr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
    [wiring.csv]
2026-08-21 R166/R167 confirmed absent; fuel pump control circuit fully resolved
    Alan verified the pair does not exist on this car - the STi diagram was being
    read by mistake on both sides. E/G(TB)-01 (WI-82) is the correct page, and
    the BY run goes R1 pin 7 straight to R122 pin 10.
    Every row on the fuel pump circuit is now confirmed.
    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
    [wiring.csv]
2026-08-21 Contents gets real page numbers; every page gets a source stamp
    Three problems, one cause: the contents page listed page COUNTS with no way
    to find a section, and once the binder was open nothing said which manual a
    page came from.
    - build-manual.py now stamps every page with tab, section, SOURCE YEAR and a
    printed page number (2-96 style). The source year is the point - sections
    from three manuals are otherwise indistinguishable in the hand.
    - It emits print/manifest.json with real start pages.
    - build-toc.py now READS that manifest. It previously carried its own
    hardcoded copy of the section list and page counts, which could drift from
    what was actually built; that copy is gone, a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
2026-08-21 Rear O2 connector repurposed for the flex fuel sensor
    An iWire rear-O2-plug to Continental-fuel-sensor-plug adapter puts the flex
    fuel sensor on B19 (4-pin grey, area B-3), the rear oxygen sensor cord. Rear
    O2 is deleted - catless, nothing to measure.
    The trap is that B19 is still physically an O2 connector, so an O2 sensor
    will plug straight in and would be feeding a flex fuel input. Recorded on the
    Tab 7 cover, in READ-FIRST and as its own wiring row.
    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
    [parts.csv, wiring.csv]
2026-08-21 Record the ECU pin swap - invisible, and only on paper
    The rear O2 signal pin was swapped with another ECU pin so the Link could use
    the signals at both ends. Specifics live only in the handwritten Link ECU
    notes and are not transcribed.
    This is the worst kind of undocumented change: the connector looks factory,
    nothing on the car indicates it, and recovery without the notes means probing
    the loom pin by pin. Flagged on the Tab 7 cover and in READ-FIRST with the
    blunt version - do not assume any ECU pin matches the factory diagram.
    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
    [wiring.csv]
2026-08-21 Drop bookmarks; navigate by page number in both directions
    Bookmarks resolved correctly here but did not work in Alan's viewer, so they
    are gone rather than left as a thing that works on some machines.
    Navigation is now printed, not embedded:
    - Every page of WRX-BINDER.pdf carries an absolute 'BINDER n' number, so the
    number typed into a PDF viewer is the number on the page. Previously the
    viewer counted 1-2013 while the stamps read per-tab (2-96), which meant
    there was no number you could type to get anywhere.
    - The contents page gains a BINDER column alongside PAGE. PAGE finds it in
    the physical binder, BINDER finds it on screen.
    Added build-all.py because the two are mutually de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
2026-08-21 Remove every link and bookmark; page numbers only
    I removed bookmarks from the combined binder last time but left them in all
    eight per-tab PDFs, which is what Alan was still seeing. Audited to zero
    across all 13 files - 0 link annotations, 0 outline entries.
    Also added link-annotation stripping to both builders. Merging re-paginates
    the source FSMs, so any cross-reference links they carry would point at the
    wrong pages.
    Replacing them, every tab cover now lists its sections with START PAGE
    (2-96) alongside the page count, so the tab's own contents works on paper.
    That plus the per-page footers and the contents PAGE/BINDER columns means
    navigation is entirely printed.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
2026-08-21 Correct the AVCS trap - the printed sections are single AVCS, not dual
    I claimed the 2007 H4DOTC manual documents DUAL AVCS and that its exhaust-
    side sprockets, solenoids and oil paths do not exist on this engine. Checked:
    there is no exhaust-AVCS content anywhere in the 2007 H4DOTC or 2005 STi
    files, and neither ME section mentions AVCS at all. Dual AVCS arrived on the
    2008 STi.
    So the printed sections MATCH the engine. The real trap is the opposite one,
    and that is what the binder now says: do not substitute a 2008-or-later
    manual, because that is where the exhaust-side hardware appears.
    Claude-Session: https://claude.ai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
2026-08-21 2005 STi EJ257 is the governing engine section; H4DOTC demoted to cross-check
    Alan built the heads to the 2005 STi documentation, and ME(STi) covers the
    whole EJ257 - short block and heads both. The binder previously pointed head
    work at ME(H4DOTC), which is the EJ255 WRX engine, on the reasoning that the
    2007 STi folder has no ME section. True, but 2005 STi does, and it is the
    right engine family.
    Both sections stay in the binder per Alan - 2005 STi labelled as the one to
    use, H4DOTC labelled cross-check only with the EJ255/EJ257 difference stated,
    and a trap saying 2005 STi wins where they disagree.
    Claude-Session: https: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
    [parts.csv]
2026-08-21 Source audit across all tabs; add the 2004 parking brake section
    Applied the Tab 2 check to every tab. Two findings:
    - TAB 5 contradicted itself. The traps say the parking brake cables are 2004
    originals and to use the 2004 procedure, but only the 2007 PB section was
    printed. Both are now in, 2004 labelled as the one to use.
    - TAB 6 wheel and tire is 2007 for a real reason - this car is 5x114.3 and
    the 2004 pages describe 5x100. Verified in the text: 2007 mentions 114.3,
    2004 never does. Now stated rather than left as a silent choice.
    Verified as correct and left alone:
    - TAB 3 CO/EX/SC from H4DOTC and H4SO. The STi versions really are 1-page
    stubs - confirmed, all three.
    - TAB 2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
2026-08-21 Keep the 2007 engine section, and say why - it is not a duplicate
    Alan asked whether the H4DOTC section is worth keeping. Diffed it against the
    2005 STi section rather than guessing:
    - Where both document a fastener, the N.m values AGREE. Apparent differences
    are ft-lb rounding of the same figure (30 N.m as 21.8 vs 22.1).
    - 2007 documents 30 torque figures to the 2005 section's 24 - con rod bolts,
    oil pump relief valve plug, tensioner bracket, V-belt cover, A/C hoses.
    - 2007 carries 9 'STI model' callouts and 5 'Except for STI' branches. The
    2005 section is STi-only so it never branches. Example that matters:
    CRANKSHAFT STOPPER is 75 N.m on STi, 72 N.m otherwise.
    So my earlier labe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
2026-08-21 Fix text running off tab covers; add an overflow check to the build
    Alan spotted clipped text on the Tab 7 cover. Measured it: trap lines were
    being drawn down to y=-50, entirely off the page. Five were invisible,
    including the fuel pump cut summary and which fuel pump diagram to use - the
    two most consequential things on that cover.
    - Tab covers now paginate their trap box instead of overflowing, with a
    (cont.) header on continuation pages.
    - That made the Tab 7 cover two pages, which silently shifted every section
    start page in that tab by one. The cover is now rendered once to measure
    its length BEFORE start pages are computed, and the build warns if a
    re-render changes that leng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
2026-08-21 Header installed: new OEM nuts, new gaskets, nickel anti-seize
    Filed CPU-83 after the fact - Phase 3 had no issue for the header itself.
    Register updates: manifold nuts and gaskets move to installed, studs row
    corrected to say the studs are in the CYLINDER HEADS rather than the block,
    and added rows for the header bung plug (crush washer in transit) and the
    nickel anti-seize.
    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
    [parts.csv]
2026-08-21 AVCS RH line is purchased and fitted; record the shortened banjo bolt
    Register had the HEL-OF34 as to-buy. It is bought - the kit is a pair and one
    is in use - and the line is fitted. What remains is shortening the banjo bolt
    4mm, since the HEL fitting is 4mm shorter than OEM.
    Added the shortened bolt as its own row. A next owner fitting a stock-length
    banjo bolt there would have it bottom in the port before clamping the banjo:
    it feels torqued and seals nothing.
    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
    [parts.csv]
2026-08-21 Note the Singer alternator as ordered, arrival unconfirmed
    Register read 'to-buy' while the notes file records it ordered on 2026-08-20.
    Neither said whether it has landed, which is the thing that actually gates
    mounting it.
    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
    [parts.csv]
2026-08-21 Singer alternator in hand; record mounting bolt torque and the open question
    Alternator arrived 2026-08-21. Mounting bolts still not located, so added a
    row for them rather than leaving it implicit.
    Generator installation torque is 25 N.m (18.1 ft-lb) per FSM SC(H4SO)-15.
    That section also flags checking V-belt tension afterwards, which this build
    cannot do yet - both belts are still on order.
    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
    [parts.csv]
2026-08-21 Add the 3/4in crank breather hose to the register
    Runs crank breather port -> OEM Y fitting -> IAG AOS. Recorded the material
    constraint on the row itself, since plain silicone is the obvious wrong pick
    here: it swells and softens in oil vapour, and this line carries hot oily
    crankcase vapour continuously.
    Length deliberately not specified - the routing may change once the turbo is
    mounted, and AOS install follows the turbo.
    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
    [parts.csv]
2026-08-21 Turbo oil drain is 5/8in ID; flag the heat sleeve as likely mis-sized
    5/8in ID agrees with the -10AN already recorded for the IAG braided line.
    That surfaced a probable error in the DEI heat sleeve row: it is listed as
    5/8in ID, but sleeve ID has to clear the hose OUTSIDE diameter. A 5/8in ID
    hose is bigger than 5/8in on the outside, and the crank breather hose is
    3/4in ID. The sleeve very likely fits neither. Marked unverified with a note
    to measure both ODs before ordering.
    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
    [parts.csv]
2026-08-21 Heat sleeve is 1in ID and in hand, not 5/8in to-buy
    Supersedes the 5/8in figure, which would not have cleared either hose OD.
    1in clears the 5/8in ID drain line comfortably. Noted that the 3/4in ID
    breather hose may still be marginal - that size hose can reach 1in OD.
    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
    [parts.csv]
2026-08-21 Track fluids in parts.csv - they existed only on the printed page
    Asked whether the gear oil and brake fluid were on hand and could not answer:
    fluids were only in build-fluids.py, which prints capacities but records
    nothing about what has been bought.
    Added a fluids system with the six that matter, each marked to-buy/unverified
    until confirmed, carrying the capacity and the trap on the row:
    - trans fill also serves the front diff and DCCD, shared sump
    - R180 is 1.0 L, not the 0.8 L R160 column
    - Torsen takes no friction modifier
    - brake and clutch are separate circuits needing separate bleeds
    - engine oil capacity is not the OEM figure because of the IAG pan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
    [parts.csv]
2026-08-21 Fluids in hand from FCP Euro
    Gear oil, brake fluid and break-in engine oil all purchased and on hand.
    Still outstanding: 300V synthetic for the post-750-mile change, and Dexron
    III for the power steering.
    Noted on the rows to keep the FCP order records - their lifetime replacement
    guarantee is worth real money on a car that will change brake fluid every
    track season and engine oil every 1200-1500 miles on E85.
    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
    [parts.csv]
2026-08-21 Record bleeder wrench and hose sizes
    02-07 WRX brake bleeders are M7x1.0, which takes an 8mm wrench - Speed
    Bleeder SB7100 is listed for 2002-2007 WRX. Clutch slave is also widely
    reported as 8mm. The change to M10x1.0 / 10mm came with the 2008 WRX.
    Marked unverified: sources cover the WRX range generally, not specifically
    the 2007 Limited 4-pot/2-pot package on this car.
    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
    [parts.csv]
2026-08-21 Bleeder hex sizes measured; thread size still unresolved
    Alan measured 8mm hex on the 4-pot fronts and 10mm hex on the 2-pot rears,
    so both wrenches are needed.
    That does NOT settle the speed bleeder choice. Hex size and thread size are
    independent - a bleeder can be M7 threaded with either hex head, which the
    forum source Alan found says explicitly. Speed bleeders are selected by
    thread: SB7100 is M7x1.0, SB1010 is M10x1.0.
    The vendor emailed SB1010 while forums report OEM 4-pots take SB7100. Left
    as undecided rather than picking, because an M10 bleeder in an M7 port
    destroys the caliper. Resolution is to pull one from each caliper type and
    measure the threaded body.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
    [parts.csv]
2026-08-21 Both speed bleeder sets ordered; note bench-comparison method
    Alan ordered SB7100 and SB1010 and will return the wrong one. Recorded the
    identification method on the row: compare against a removed OEM bleeder on
    the bench, never test-fit in the caliper.
    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
    [parts.csv]
2026-08-21 Correct bleeder provenance; drop the speed bleeder row
    Two fixes:
    - I recorded the 8mm/10mm hex sizes as measured on the car. They were not -
    that came from NASIOC. Marked unverified with the real source.
    - Removed the speed bleeder row entirely. OEM nipples are being retained, so
    the SB7100-vs-SB1010 thread question is moot.
    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
    [parts.csv]
2026-08-23 Record BC coilover spec sheet; note King race-series bearings
    Coilover paperwork found 2026-08-23: BR type converted to DS, 05-07 STI/GDF
    application (resolves the F-02 vs F-03 question), 62.200.8 / 2.220.6k
    springs, pillowball camber fronts, rubber rears, RA upper mount.
    Rod/main bearings were already King in the register; now marked as the
    race series on the CSV, register, and engine specs.
    Claude-Session: https://claude.ai/code/session_01Y2W9VmnogqjsEarFfJp8Pi
    [parts.csv]
2026-08-23 Record King CR4125XPG STDX pMax Black rod kit; flag STD/STDX question
    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
    [parts.csv]
2026-08-24 Track OpenSCAD sources for 3D prints; battery tray v14
    Narrow the "3D Prints/" exclusion to "3D Prints/**" plus a negation for
    *.scad, so the parametric sources are versioned while the STL/3MF/gcode
    exports stay out. A bare directory exclusion cannot be negated from
    inside it, hence the /** form.
    Battery tray at v14:
    - heat shield tie slots removed (include_hs_tie_slots = false). They were
    added to clamp an alternator descent against the shield face, but the
    run now loops in open bay off the X_MIN side and is clamped only at the
    fuse wall, so the shield needs no penetrations.
    - cable-layout.scad: alternator redrawn as one continuous 60mm U. Loop
    plane tilted 37 deg off t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
    [battery-tray-mtx35.scad, cable-layout.scad, fpr-bracket.scad, fpr-carrier.scad, fuse-insert-dia-test-2.scad, fuse-insert-dia-test-3.scad, fuse-insert-dia-test.scad, fuse-platform-test.scad]
2026-08-25 Correct piston PN to Manley 612002C-4; record box label details
    PN read off the actual box 2026-08-25 (register had 612000C-4).
    Platinum Series dished, 99.75mm, 1.209" CH, with rings, 410-411g
    without pin per the 08/13/20 box label.
    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
    [driver-side-bracket.scad, flex-fuel-assembly.scad, parts.csv]
2026-08-25 Turbo bearing type resolved: journal, per previous owner
    PO (original purchaser) spec: welded internal WG flapper, 10cm hot side,
    billet wheel, JB, 84mm cover, ~15k mi low-boost street. Oil feed is
    therefore full-flow with no restrictor.
    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
    [parts.csv]
2026-08-25 Record ~160k mi chassis mileage in register header
    Component mileages were already noted (6MT 97k at install, turbo ~15k
    per PO) but the wagon chassis itself had no odometer record.
    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
2026-08-25 Break-in protocol: update wastegate spring premise to 10.15 psi
    The no-boost-until-tune conclusion is unchanged - it rests on the
    untuned base map, not the spring value.
    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
2026-08-25 Spark plugs: NGK 2309 LFR7AIX gapped 0.027in, supersedes ILTR7L8R record
    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
    [parts.csv]
2026-08-25 Record asymmetric front ABS sensor config
    One side: full aftermarket 01-06-pattern sensor. Other side: 05-07 STi
    knuckle sensor with transplanted connector (source of the black/white
    crossover). Both passive VR, compatible with the 04 module; CPU-91
    covers verification.
    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
    [parts.csv]
2026-08-26 Break-in runs on the green 4.35 psi WG spring; 10.15 goes in before the tune
    Alan loaded the TiAL MVS with the single green small spring (0.3 bar) for
    first start and break-in. Research confirmed lowest-spring-for-break-in is
    sound, but a 3-port EBCS only controls to ~2.5-3x spring, so 4.35 cannot
    reach the 26-29 psi target — swap to 10.15 after break-in, before the dyno
    tune (tracked on CPU-34).
    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
2026-08-26 Driver-side bracket v3: relayout from v1 fitment, shroud mount, sensor cutout
    v1 test fit findings: boss tilt is ~20 not 30, the FPR's right fitting hit
    the fuse box at the drawn spot, bottom-right corner bumped the chassis.
    - FPR moved low-left (ears 43/95 @ -98); flex sensor flipped 180 to the
    right, final pose (30.7, -88) rot 116; vapor floor relaxed 30->25 with
    provenance (our margin, not a spec - AEM allows any orientation)
    - Mount reformed: twin arms -> full-width shroud with continuous seat bar,
    cove fillet at the panel joint, 3mm boss clearance
    - ffs_clearance_cut(): cradle+sensor dilated 3mm and subtracted from the
    body, so struts may bind anywhere and the sensor molds its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
    [driver-side-bracket.scad, flex-fuel-assembly.scad]
2026-08-26 Bracket M5 nut pockets: nut-deep only, clamped floor 1.8 -> 3.1mm
    The 1.5mm "thread relief" past the nut was thinning the floor for nothing:
    the bolt enters from the front, so its tip runs out into the pocket's own
    open rear mouth. Pocket is now nut_thickness + 0.2 seating fit; nut sits
    just sub-flush of the back face. v3 prototype STL exported from this state.
    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
    [driver-side-bracket.scad]
2026-08-28 Driver-side bracket v4: full fitment rework from v3 test fit
    Sensor repositioned (61,-57,105deg + 15deg forward tip) with wedge backing
    pad, normal-drilled M5s with angled rear nut pockets, auto-aimed inlet hose
    ghost. FPR down 5mm. Studs lifted 5 (body hangs lower), squares extended,
    right pocket +5 radial. Top corners dropped 13 both sides, arms re-rooted
    as full buttresses meeting the pad. Right edge pulled to -16 off the fuse
    box. Third M5 mount w/ counterbore, rear-face version engraving, projection
    pin artifacts closed, smooth pocket walls (outline cut, not copy-dilation).
    Claude-Session: https://claude.ai/code/session_01Y2W9Vmnog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
    [driver-side-bracket.scad, flex-fuel-assembly.scad]
2026-09-02 Driver-side bracket v6: derived flush top edge, sensor re-placed from v5 fit
    v5 at-car fitment: the panel's lower half stood off the pillar wall, so
    chassis_hole_tilt goes 10 -> 13. That angle has now been walked 30 -> 20 -> 10
    -> 13 entirely by eye and has still never been measured at the car.
    Sensor re-placed to (73, -44) rot 125 from (61, -57) rot 105.
    Flush top edge is now derived rather than tuned. ffs_backing() was capped by a
    plane hand-fitted to one ffs_oz (ffs_pad_top_inset = 4.699), so every vertical
    move of the sensor either pushed the pad through the flat top face or left a
    gap under it. ffs_top_limit() replaces it: across the seat bar's span the
    boundary is the bar's own top f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
    [driver-side-bracket.scad]
2026-09-15 Driver-side bracket v7: sensor re-placed, boss pocket splits, exact sensor cut
    - Sensor cradle moved to ox 80 / oz -41, new ffs_oy 2mm stand-off, rot 130
    - chassis_hole_tilt 13 -> 14
    - Boss pockets: right extra radial 1 -> 3, per-face inner clearances,
    2mm cove fillet at the pocket mouth
    - Bottom edge held flat left of the FPR right ear
    - Sensor pocket: ffs_cut_clear 3 -> 1, sphere minkowski replaces shifted
    copies, ffs_cut_close closes cradle ear holes in the projection
    [driver-side-bracket.scad]
2026-09-15 Driver-side bracket v8: split mount tilt, re-drawn fuse box, sensor 136°
    From the v7 test fit:
    - Seat tilt per mount: right 14 -> 8 (new chassis_hole_tilt_r), left
    14 -> 12. One pad per boss, hull-blended; fillets and backing clips
    follow the blend via tilt_at()/tilt_slices()
    - Fuse box keep-out: 75mm tall, notch full height, left face -20 -> 9.2
    - Sensor turned to 136° about its body centre, origin (79.45, -39.35)
    - sensor() takes boot = false; the bracket no longer draws the loom
    - Drop clash check 6
    [driver-side-bracket.scad, flex-fuel-assembly.scad]
2026-09-15 Binder: drop GD(STi) and 2007 ME(H4DOTC), 2004 ABS/PB, colour/mono split
    - Remove GD(STi) General Description (OEM ECU DTC criteria, void on the Link)
    and the 2007 ME(H4DOTC) section; 2005 ME(STi) is the sole mechanical source
    - Print the 2004 ABS and parking brake sections as governing, 2007 as cross-check
    - Add build-colorsplit.py (colour vs mono print sets) to build-all
    - Contents page paginates; overflow check reads Tm operands directly
    - Print index page budget: 1678 binder pages, 839 sheets duplexed
2026-09-15 Battery tray: bridge bar and Blue Sea 5001 models, bridge view presets
    [bridge-bar.scad, cable-layout.scad, fuse-holder-5001.scad]
2026-09-15 Notes: wheels/pads, clutch slave rebuild, grounding revision, inlet clamp
    - Brakes: wheels identified (17x8 ET55), Hawk HB700B pads, Brembo dropped
    - Cooling: manifold year decoupled from the cooling circuit
    - Drivetrain: original slave rebuilt, aftermarket unit returned
    - Grounding: GE-1/GB-1 corrected, 1/0 chassis run, 225A MEGA, bridge bar
    - Parts register: turbo inlet clamp, PCV balance lines, clutch slave kit
    [parts.csv]
2026-09-15 Binder covers: print tab notes last-edited date, fix column heading overlap
    - Each tab cover prints the date its title, subtitle, traps or section list
    last changed, tracked by content hash in manual/cover-dates.json
    - Widen the SOURCE YEAR column so it no longer overprints START PAGE
2026-09-16 Driver-side bracket v9: left boss 10mm deeper, sensor 137°
    - Left chassis boss ghost and pocket extend 10mm down (boss_drop_l);
    the left arm body was bumping the chassis mount behind the seat pad
    - Sensor turned 1° CW about its body centre and slid 2mm right along
    the fuel passage
    - Version tag v9
    [driver-side-bracket.scad]
2026-09-16 Driver-side bracket v10: FPR turned 5° CW and down 5mm, third M5 moved
    - New fpr_rot turns the FPR ghost and its printed ear holes together
    about the ear midpoint; the flat bottom edge follows the right ear
    - FPR ear line 5mm lower (fpr_ear_z -108)
    - Third M5 hole (15,-88) -> (38,-89), out from behind the sensor inlet hose
    - Version tag v10
    [driver-side-bracket.scad]
2026-09-16 Driver-side bracket: panel round-over as stacked insets, not minkowski
    Minkowski on the curved bottom edge left zero-area sliver faces that
    Bambu Studio flagged as non-manifold edges. Eight inset layers per side
    (0.19mm each) give the same 1.5mm round-over with a clean mesh.
    [driver-side-bracket.scad]
2026-09-21 Driver-side bracket v11: left boss U modelled per-leg, FPR 7°, sensor yawed
    Split the left boss pocket into two legs with their own reach and air. The
    outer leg ramps from the pillar wall to the seat plane; the boss ghost models
    the legs so it no longer tracks the pocket. Adds check 6 for bracket against
    the chassis bosses, which that change makes meaningful.
    Closes the opening where the left arm meets the pad's back. boss_pocket_fillet_r
    2 -> 1 to buy it: the cove pulls every pocket face in by its full radius, so it
    must stay under the smallest clearance.
    FPR to 7° and 1mm further down its tilted axis. Sensor 4mm down its own axis,
    which alone put it inside the fuse box; ffs_yaw 2° abo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
    [driver-side-bracket.scad]
2026-09-23 Driver-side bracket v12: cable-tie slots, embedded FPR nuts on a raised pad
    - Zip-tie slot pair for the sensor connector cable at (-6, -72), with a
    rear-face channel for the band
    - Bottom edge under the FPR dropped 3mm; flat meets the curve without a step
    - Third M5 moved down 5mm to (38, -94)
    - FPR nut pockets closed for embedding at a Z 6.0 print pause, with a
    stepped bridge over each nut
    - 2mm chamfered pad under the FPR's steel bracket, spanning both ears down to
    the bottom edge: 4.0mm of plastic over each nut; FPR sits 2mm forward
    - Track BUILD-NOTES.md under 3D Prints alongside the .scad sources
    [driver-side-bracket.scad]
